Aviboi/sails/data/Hull Form.STL

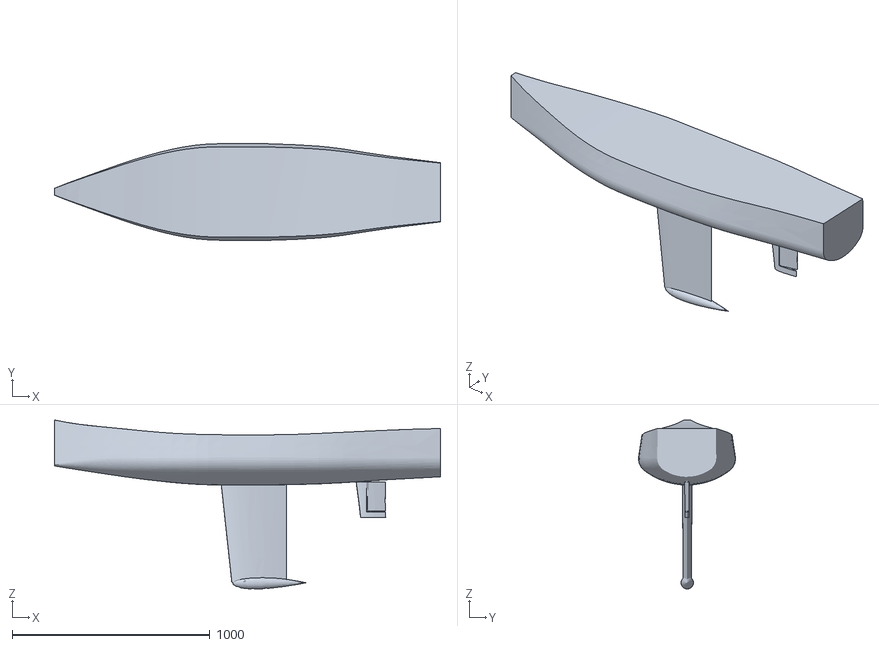
[picture p1: CAD file, 2026-11-06]
data/Hull Form.STL
1950.3 x 489.8 x 853.8
