Aviboi/sails/(commit log)

2026-11-01 Split off hull calcs
2026-11-06 Clean slate
    [heeled_buoyancy_curves.csv, hull_stations_from_CAD.csv, run_matrix.csv, section_f06.0pct.csv, section_f07.0pct.csv, section_f08.0pct.csv, section_f08.0pct_spine.csv, section_f09.0pct.csv]
2026-11-06 Add new hull import and hydrostatics script
    [Hull Form.STL]
2026-11-06 Factor STL import into reusable geometry_form/load_geometry helpers
2026-11-06 Use combined hull/keel/rudder STL and update docs
    The STL now contains hull, keel and rudder as one solid, so drop the
    empty keel/rudder import placeholders, measure heights from the keel
    tip, default the waterline to the 80 kg equilibrium, and add the rtree
    dependency needed by trimesh slice_plane(cap=True).
    [Hull Form.STL]
2026-11-06 Compute Cb and Cwp for hull shell only, excluding keel and rudder
    Add hull_shell() to cut the hull above the appendages, and let hydrostatics()
    take it to compute form coefficients and draft from the shell alone.
2026-11-06 Add wetted areas, lateral plane, form coefficients, metacentric heights and stability limits
    Split wetted surface into hull shell, keel and rudder with fin planform
    properties and lateral plane centroid. Add Cm, Cp, LCB and entrance
    half-angle, KM/GM/MCT1cm, and downflooding/vanishing-stability limits
    on the GZ curve.
2026-11-06 Add windage and freeboard: side/frontal areas above waterline
    Project the hull above the waterline onto the centerline and transverse
    planes with centroid heights and freeboard along the length. profile_union
    now takes the projection axes.
2026-11-06 Add mass moments of inertia and added mass with 3D fin correction
    Radii of gyration from the mesh and assumed ratios, dry inertia, strip-theory
    added mass with a finite-span factor on the keel and rudder sway contribution,
    and a natural roll period estimate.
2026-11-06 Add sail design outline, environment, and hydrodynamic forces; flip hull import
    Add the Sail Design outline, wind and air inputs with a power-law profile,
    and crossing target and design limits. Add calm-water resistance (ITTC-57
    friction, Holtrop form factor, appendage friction, Michell wave resistance
    with transom fairing) and keel/rudder side force with induced drag.
    Flip the hull import so the bow is +x, sort fins fore to aft by descending
    x, and mirror the placeholder LCG and mast step to keep their positions.
2026-11-06 Add wing-sail aerodynamics: planform, NeuralFoil section data, finite-span polar, mast torque
2026-11-07 Add force balance, sail sizing, structural loads and design summary
    Force balance over points of sail with heel, leeway, helm and a Viterna-Corrigan
    post-stall extension of the sail polar; sail area/aspect-ratio sweep; mast and
    step load cases with spar sizing and rig mass; pass/fail design summary.
    Sail area set to 1.5 m^2.
2026-11-07 Add mast drivetrain and motor sizing
    Required mast torque (aero, friction, inertia) through a reduction
    gearbox, with motor torque, speed and holding-power checks, and
    matching rows in the design summary.
2026-11-07 Resolve P2 model consistency items
    Flip hull on import and label fins by area, solve draft from hull mass,
    add all-up rig mass and stability check, include hull windage in the force
    balance, and show transom fairing sensitivity in the design summary.
2026-11-10 Centralise notebook inputs in a typed Inputs section
    All widget defaults and previously hard-coded constants now live in five
    cells at the top of the notebook (design, requirements, estimates,
    assumptions, constants), each entry a Param(value, unit, note). Widgets
    stay next to their calculations and take their default from these cells,
    so edits persist across kernel restarts and mark dependents stale. A
    drift cell lists widgets that differ from their defaults.
    Defaults are set to the values used in the last working session (hull
    mass 30 kg, sail 0.75 m^2 at AR 2.0, mast at 24% chord, 3/12/45 kn winds,
    1000 nm in 40 days, hull KG 0.125 m, LCG 0.94 m, resistance table to
    10 kn). Update CLAUDE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
2026-11-11 Add mast sizing sweep by sail area and aspect ratio
    Finds the lightest mast tube that keeps the survival tip deflection under
    the limit, for each sail area and AR on the sail-sizing grid.
2026-11-11 Add design study section with margin maps and sweeps
    Add evaluate(d), which returns a margin for each check of one design
    (sail area, aspect ratio, mast step, deck gap, mast tube OD and ID),
    with a uniform mast tube, a fast mass-interpolated righting moment and
    stock tube snapping. A Design Study section shows a survivability and
    stability map over sail area and aspect ratio with threshold contours,
    margin-line sweeps for the mast tube and mast step, and a table of what
    binds at the current design. Rig, helm and step helpers take an optional
    mast step. Includes the design spec and implementation plan.
